diego2704/Clifford-Sensors/tesis/DOCUMENTACIÓN/RUP/DIAGRAMA DE SECUENCIAS.docx

# DIAGRAMAS DE SECUENCIA

Tabla de contenidos

1 | Comunicación en tiempo real de los sensores | …1
2 | Comunicación entre Arduino Nano | …2
3 | Comunicación entre Arduino Nano y Raspberry Pi | …3
4 | Detección de Gases. | …4
5 | Debe ser capaz de adaptarse a situaciones imprevistas o escenarios no programados, demostrando flexibilidad y toma de decisiones autónomas. | …5
6 | Se requiere que la plataforma opere de manera eficiente desde el punto de vista energético para maximizar su autonomía y minimizar el impacto ambiental. | …6
7 | Generación de Comandos por Entrada de Voz. | …7
8 | Medición del esfuerzo en las patas de la plataforma cuadrúpeda | …8
9 | Medición de la Orientación de la Plataforma | …9
10 | Estimación de la Posición utilizando GPS NEO6M | …10
11 | Medición del Consumo de Voltaje y Corriente | …11
12 | Interfaz de Usuario Intuitiva y Efectiva. | …12

1. Comunicación en tiempo real de los sensores.

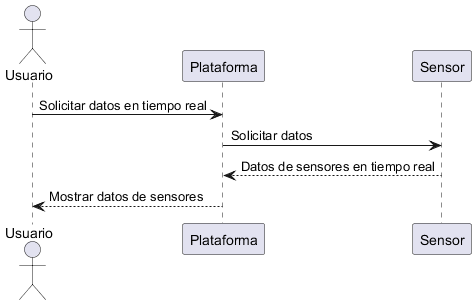
[picture p4: figure]

2. Comunicación entre Arduino Nano.

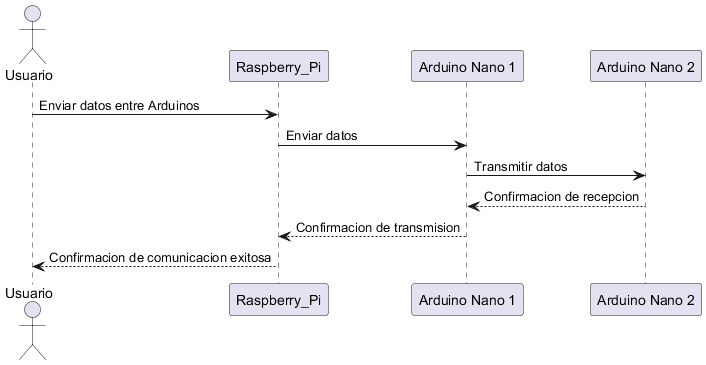
[picture p5: figure]

3. Comunicación entre Arduino Nano y Raspberry Pi.

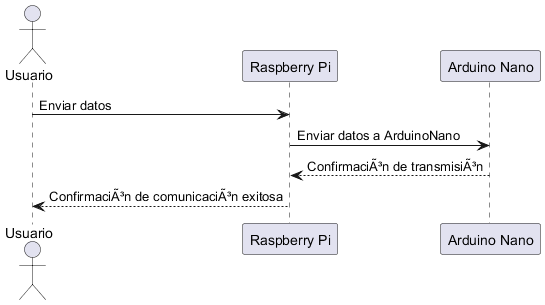
[picture p6: figure]

4. Detección de Gases.

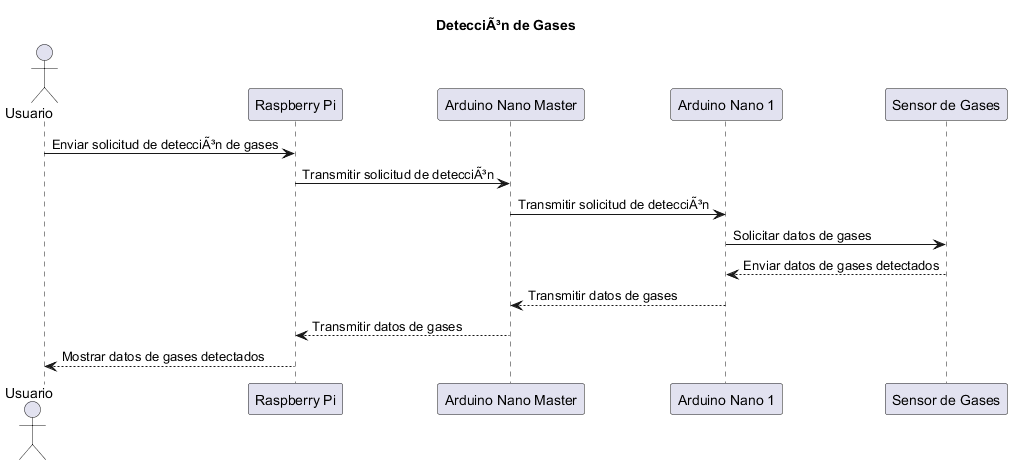
[picture p7: figure]

5. Detección de Objetos por Cámara.

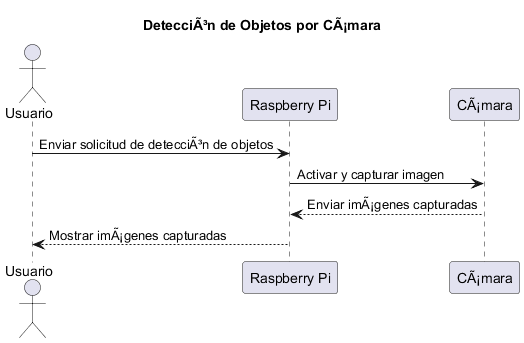
[picture p8: figure]

6. Detección de objetos por LIDAR 2D

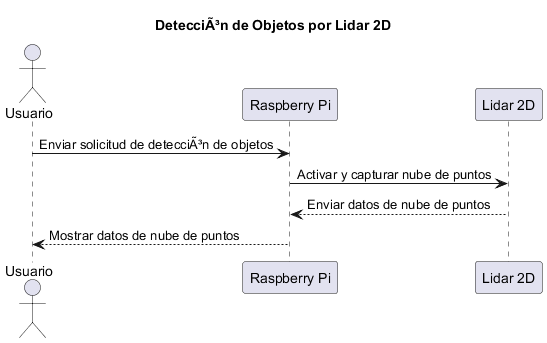
[picture p9: figure]

7. Generación de Comandos por Entrada de Voz.

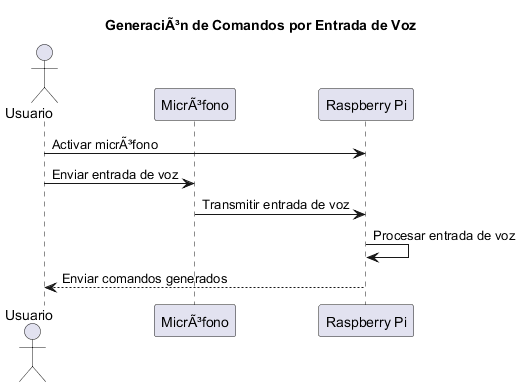
[picture p10: figure]

8. Medición del esfuerzo en las patas de la plataforma cuadrúpeda

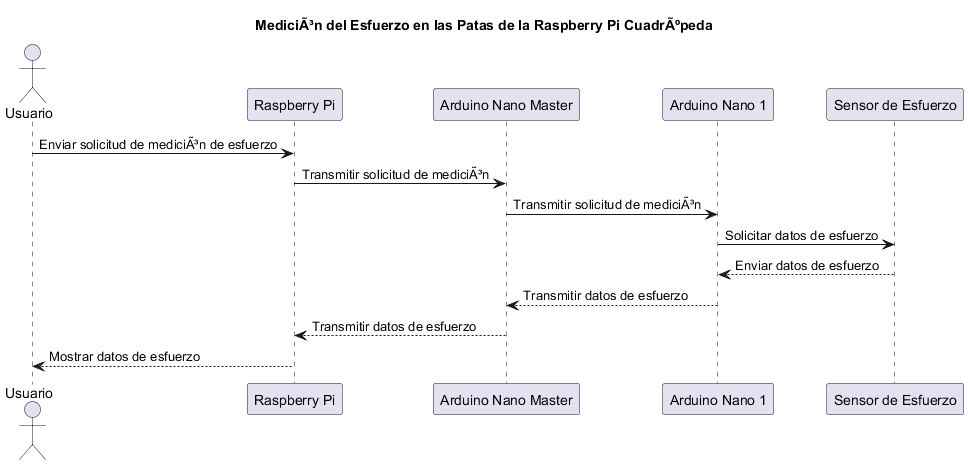
[picture p11: figure]

9. Medición de la Orientación de la Plataforma.

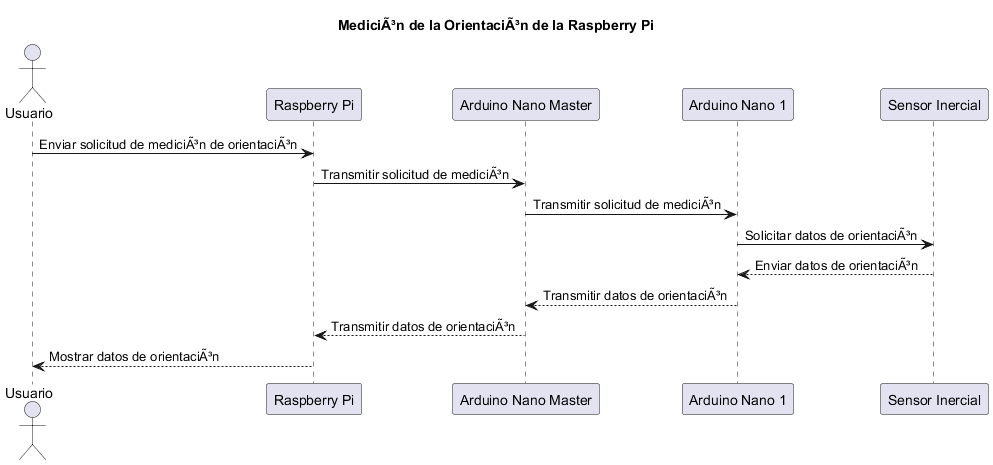
[picture p12: figure]

10. Estimación de la Posición utilizando GPS NEOM8N

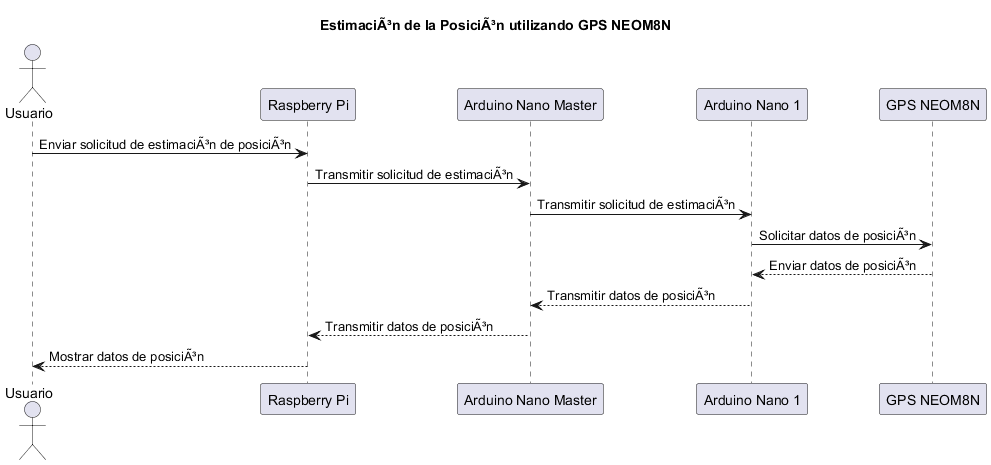
[picture p13: figure]

11. Medición del Consumo de Voltaje y Corriente

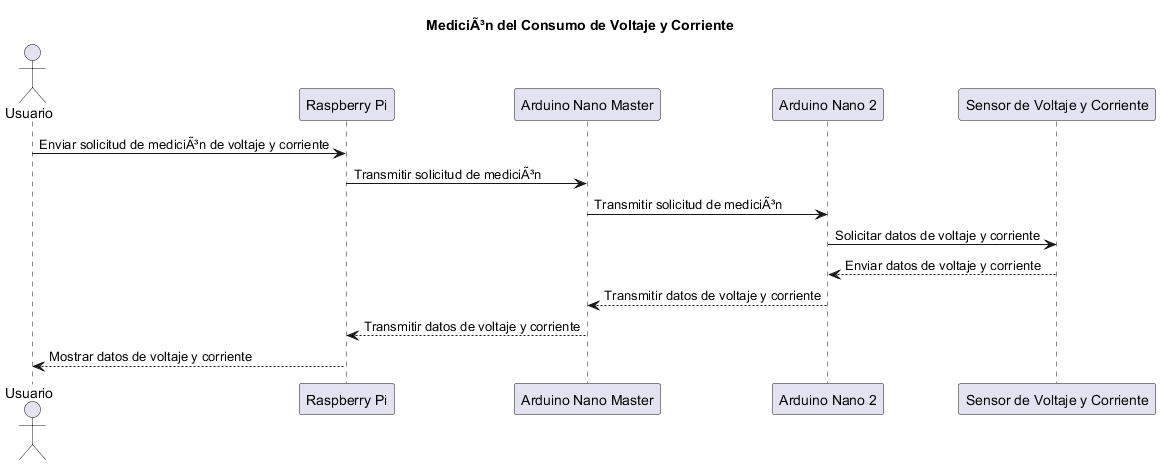
[picture p14: figure]

12. Interfaz de Usuario Intuitiva y Efectiva.

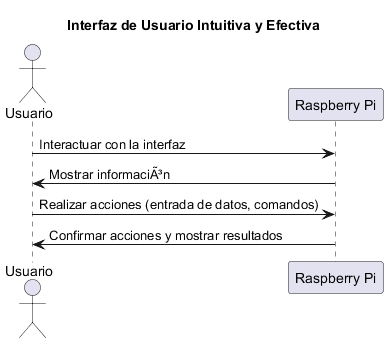
[picture p15: figure]
