diego2704/Clifford-Sensors/tesis/DOCUMENTACIÓN/RUP/DIAGRAMA_DE_CLASES.docx

DIAGRAMA DE CLASES

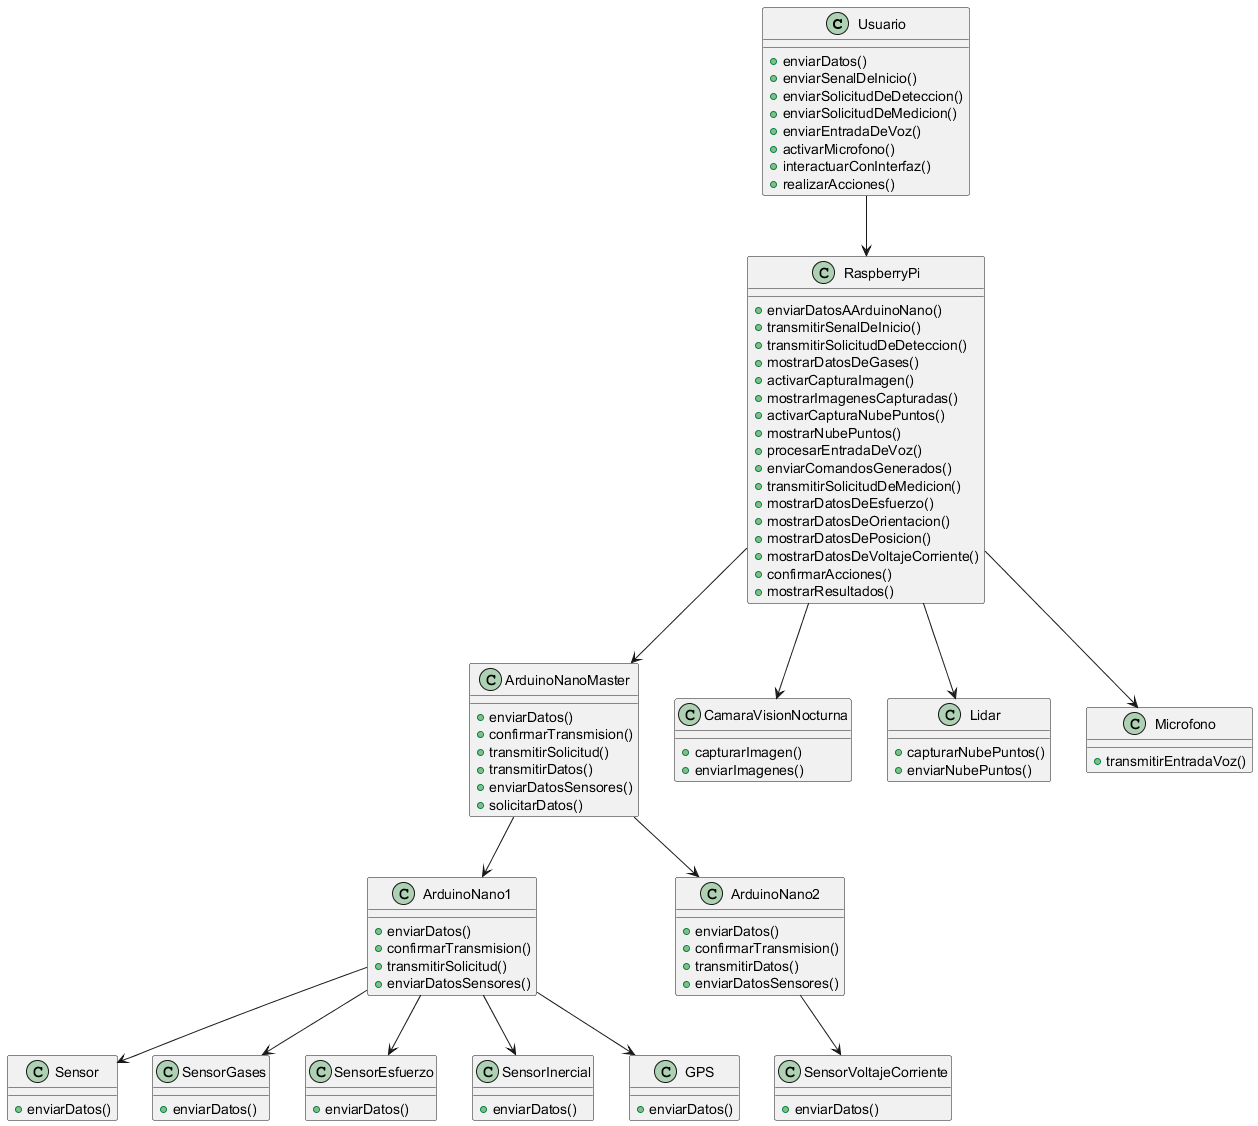
[picture p16: figure]
