diego2704/Clifford-Sensors/tesis/DOCUMENTACIÓN/ESQUEMATICO/esquematico.png

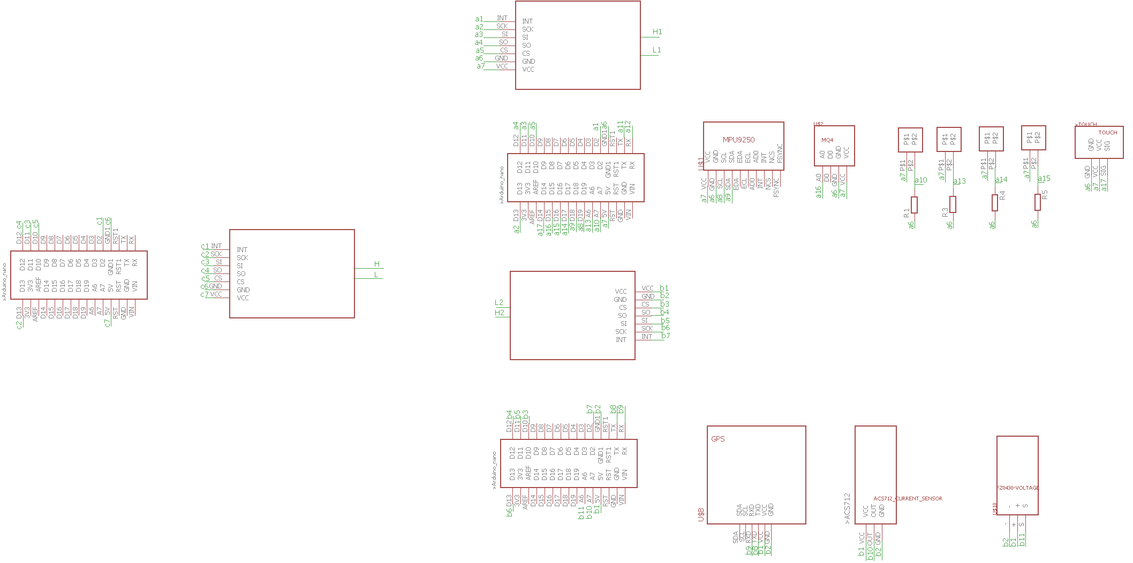
tesis/DOCUMENTACIÓN/ESQUEMATICO/esquematico.png
