diego2704/Clifford-Sensors/tesis/DOCUMENTACIÓN/ESQUEMATICO/PCB1.png

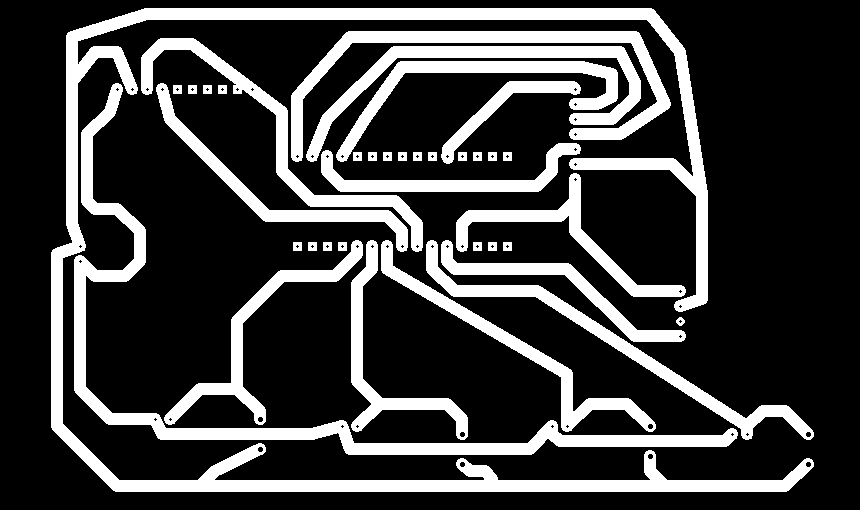
tesis/DOCUMENTACIÓN/ESQUEMATICO/PCB1.png
