diego2704/Clifford-Sensors/tesis/DOCUMENTACIÓN/ESQUEMATICO/PCB2.png

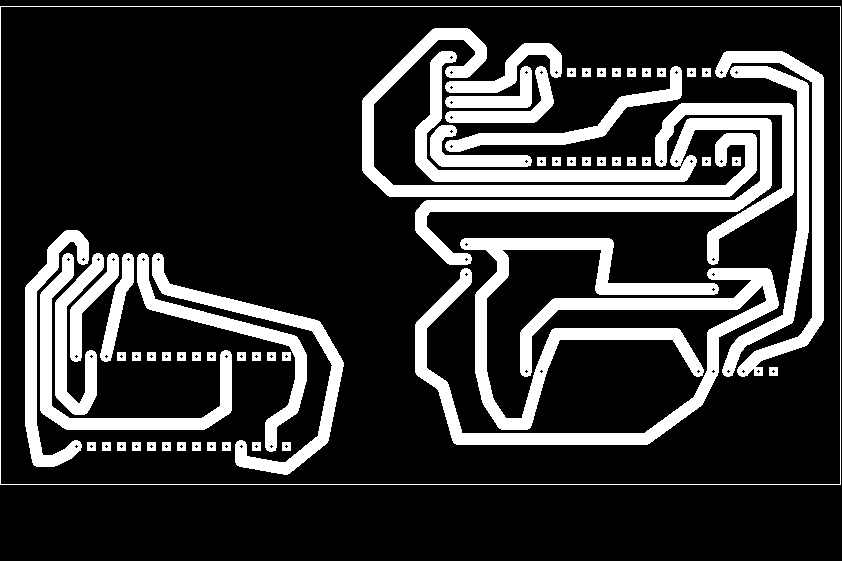
tesis/DOCUMENTACIÓN/ESQUEMATICO/PCB2.png
