diego2704/Clifford-Sensors/tesis/DOCUMENTACIÓN/EVIDENCIAS/Imagen de WhatsApp 2024-08-28 a las 14.34.12_500f0fdd.jpg

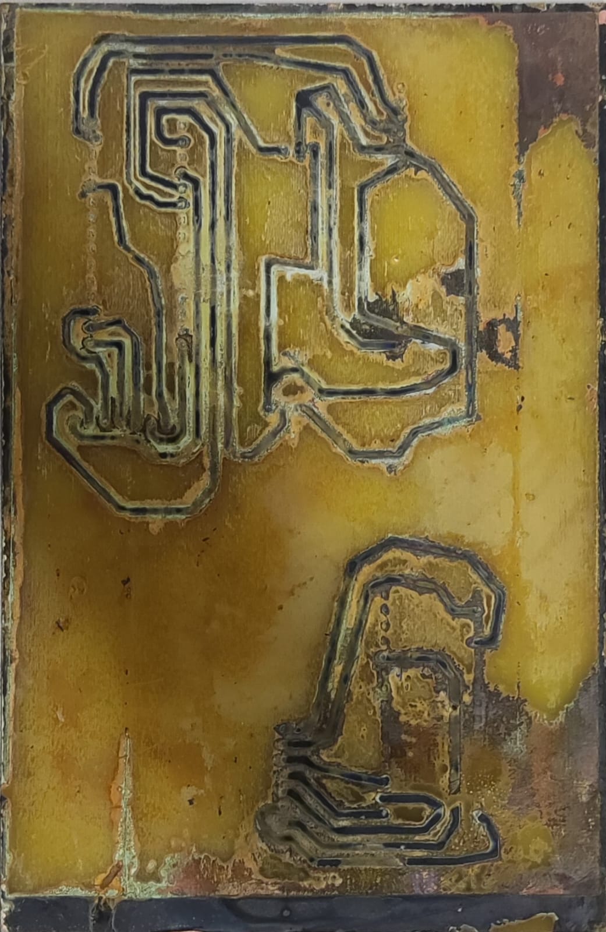
tesis/DOCUMENTACIÓN/EVIDENCIAS/Imagen de WhatsApp 2024-08-28 a las 14.34.12_500f0fdd.jpg
