diego2704/Clifford-Sensors/tesis/DOCUMENTACIÓN/EVIDENCIAS/Imagen de WhatsApp 2024-08-28 a las 14.34.12_a7c47f93.jpg

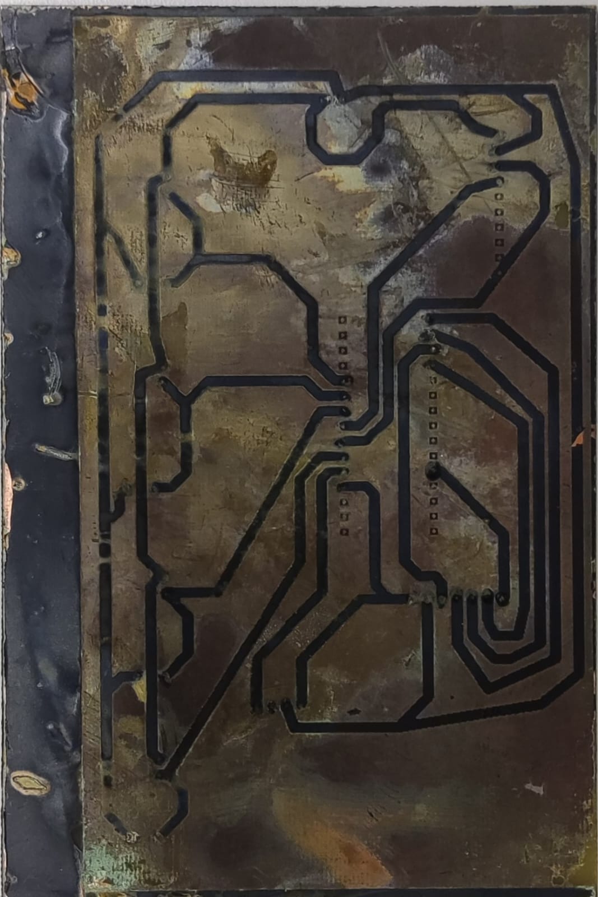
tesis/DOCUMENTACIÓN/EVIDENCIAS/Imagen de WhatsApp 2024-08-28 a las 14.34.12_a7c47f93.jpg
