diego2704/Clifford-Sensors/tesis/CODIGOS/1.Interfaz/segunda entrega/POCHITA_v30.stl

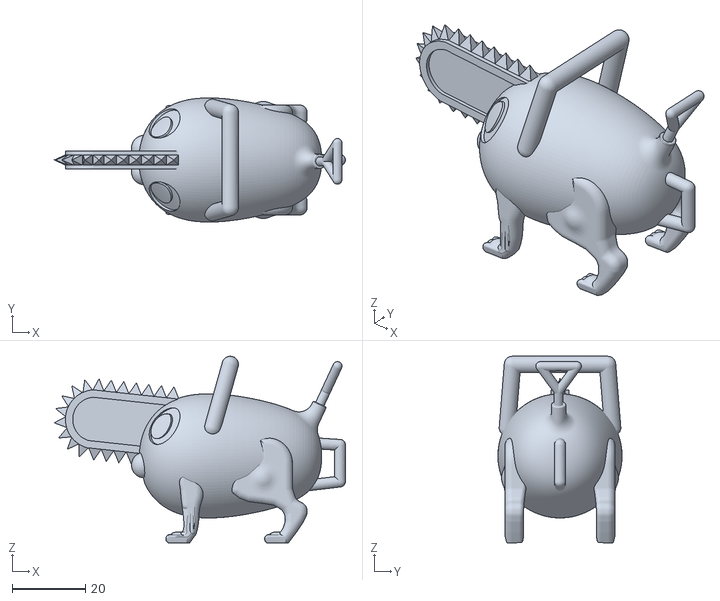
[picture p27: CAD file, 2024-10-07]
tesis/CODIGOS/1.Interfaz/segunda entrega/POCHITA_v30.stl
79.5 x 33.9 x 51.0
