diego2704/Clifford-Sensors/(list of files, drawings)

Other design files:
tesis/CODIGOS/esquematico_doggy.fzz
