diego2704/Clifford-Sensors/tesis/DOCUMENTACIÓN/ESQUEMATICO/es11quematico_tesis_brd.brd

## EAGLE design tesis/DOCUMENTACIÓN/ESQUEMATICO/es11quematico_tesis_brd.brd (2024-08-28)

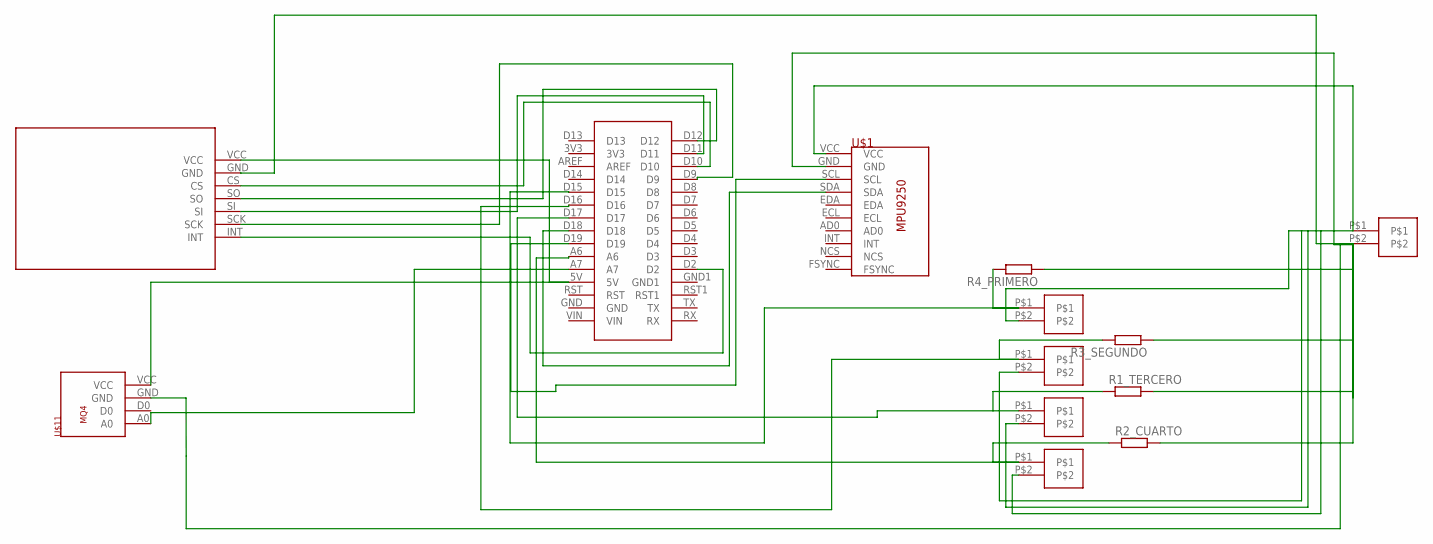
[picture p28: schematic es11quematico_tesis_brd.sch]

Parts:
ALIMENTACION: FSR402
CUARTO_FSR: FSR402
PRIMER_FSR: FSR402
R1_TERCERO, R2_CUARTO, R3_SEGUNDO, R4_PRIMERO: R-EU_0613/5V; P0613V
SEGUNDO_FSR: FSR402
TERCER_FSR: FSR402
U$1: MPU9250
U$2: ARDUINO-NANO
U$8: MCP2515
U$11: MQ4

Connections:
unnamed: ALIMENTACION.P$1, CUARTO_FSR.P$2, PRIMER_FSR.P$2, SEGUNDO_FSR.P$2, TERCER_FSR.P$2, U$1.VCC
unnamed: U$2.D10, U$8.CS
unnamed: ALIMENTACION.P$2, R1_TERCERO.2, R2_CUARTO.2, R3_SEGUNDO.1, R4_PRIMERO.1, U$1.GND, U$8.GND, U$11.GND
unnamed: U$2.D12, U$8.SO
unnamed: U$2.D11, U$8.SI
unnamed: U$2.D9, U$8.SCK
unnamed: U$2.D2, U$8.INT
unnamed: PRIMER_FSR.P$1, R4_PRIMERO.2, U$2.D15
unnamed: U$2.A7, U$11.A0
unnamed: U$1.SCL, U$2.D19
unnamed: U$1.SDA, U$2.D18
unnamed: CUARTO_FSR.P$1, R2_CUARTO.1, U$2.A6
unnamed: R1_TERCERO.1, TERCER_FSR.P$1, U$2.D17
unnamed: R3_SEGUNDO.2, SEGUNDO_FSR.P$1, U$2.D16
unnamed: U$2.5V, U$8.VCC, U$11.VCC

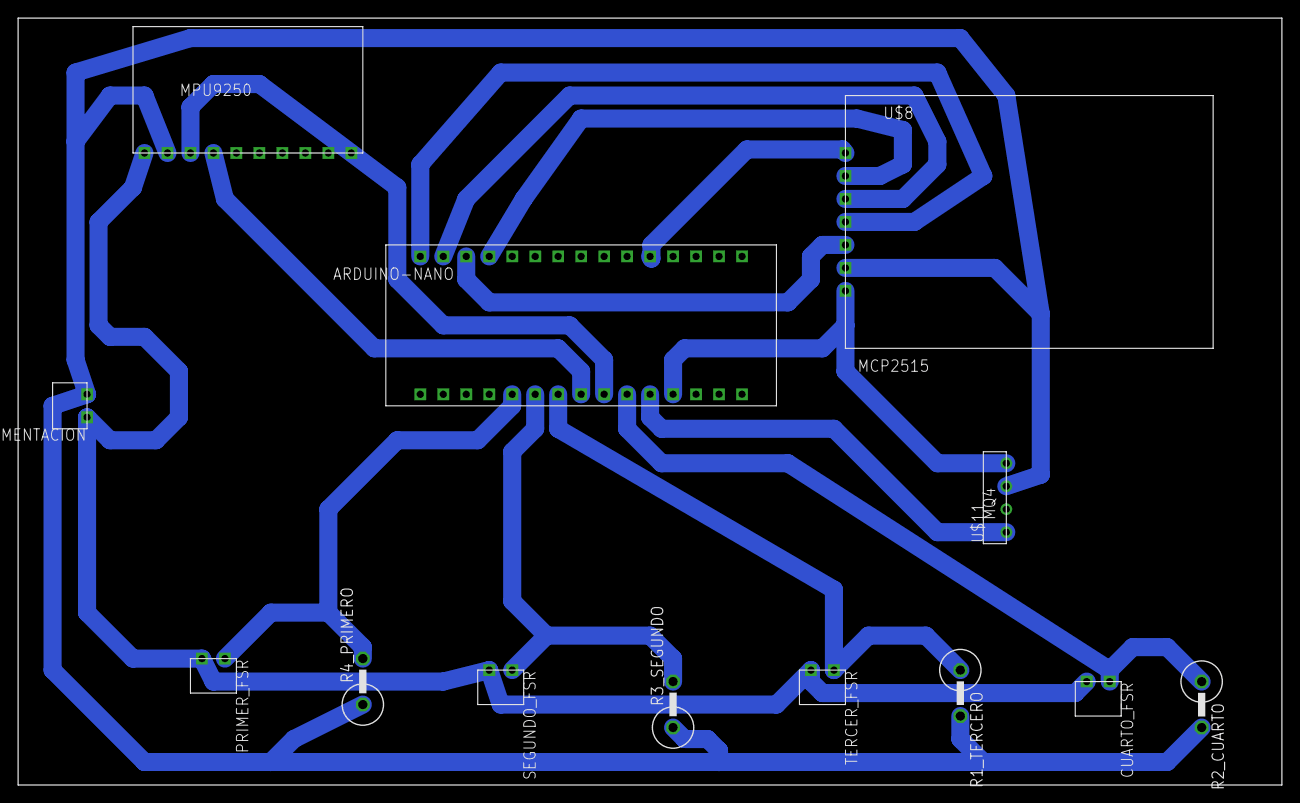
[picture p29: board es11quematico_tesis_brd.brd from above]

Board: 2 copper layers, 139.7 x 84.8 mm, 13 parts (0 on the bottom side), 15 nets.
