diego2704/Clifford-Sensors/tesis/CODIGOS/esquematico.sch

## EAGLE design tesis/CODIGOS/esquematico.sch (2024-08-21)

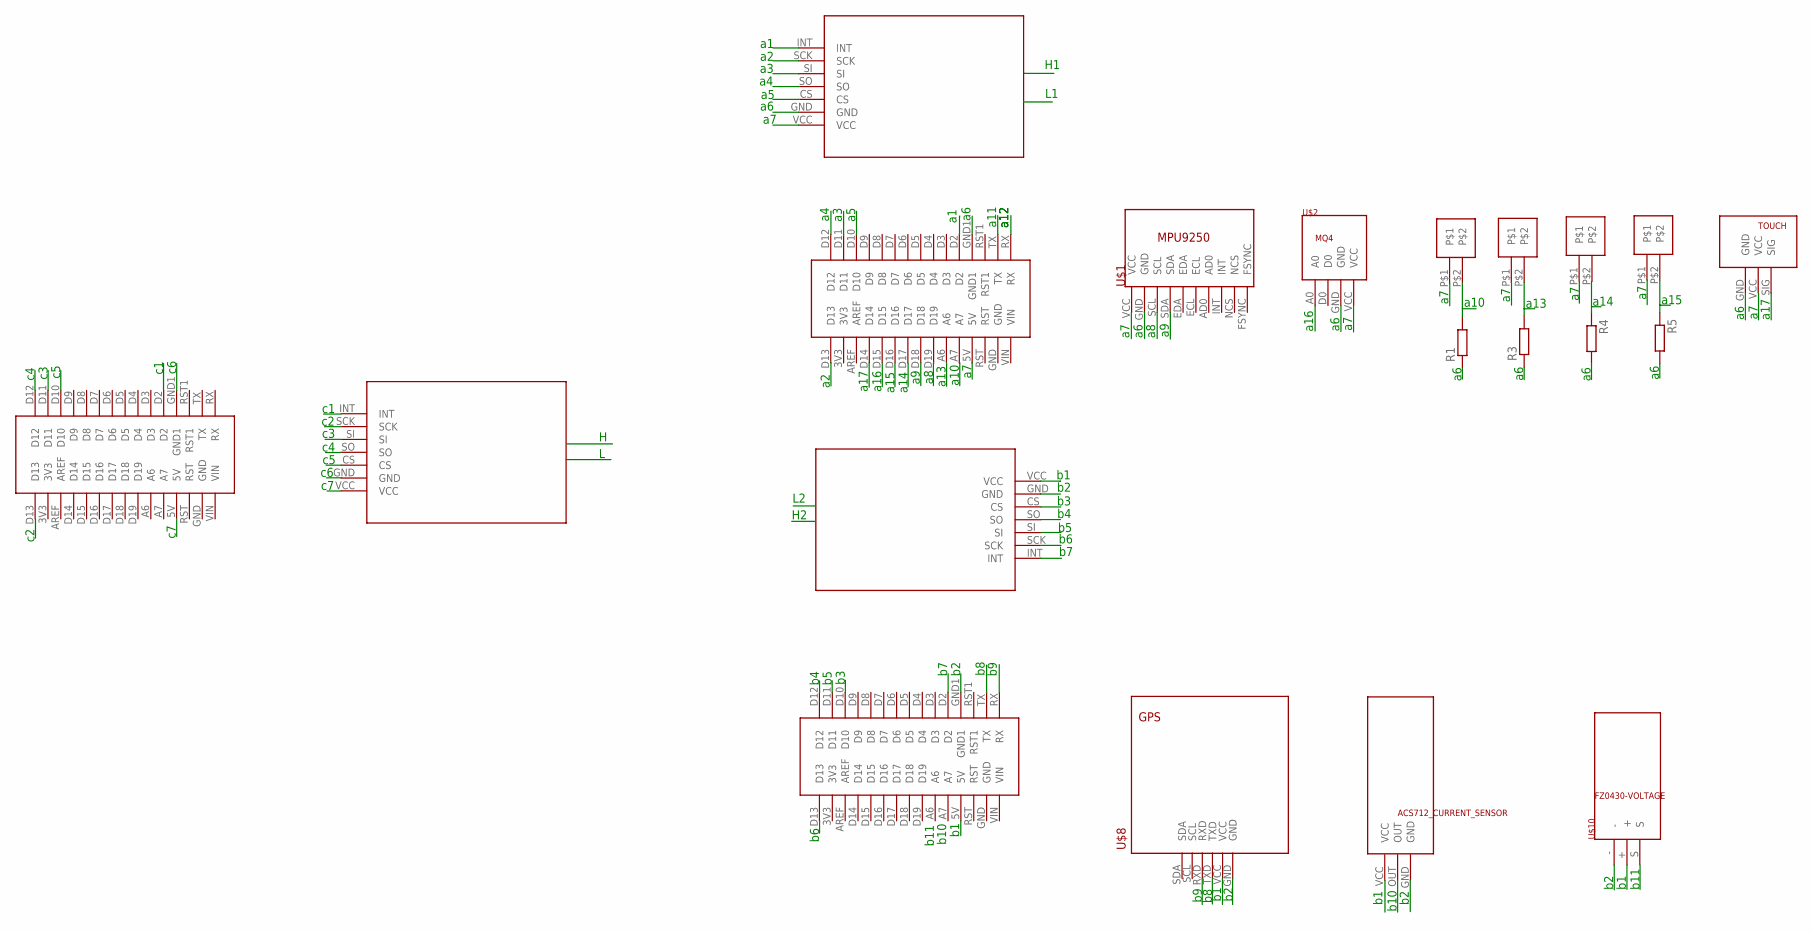
[picture p30: schematic esquematico.sch]

Parts:
R1, R3, R4, R5: R-EU_0204/5; 0204/5
U$1: MPU9250
U$2: MQ4
U$3, U$4, U$5, U$6: FSR402
U$7: TOUCH
U$8: GPS
U$9, U$15, U$16: ARDUINO-NANO
U$10: FZ0430-VOLTAGE
U$11: ACS712_CURRENT_SENSOR; ACS712-VOLTAGE
U$12, U$13, U$14: MCP2515

Notes on the sheet:
a10
a11
a12
a13
a14
a15
a16
a17
b10
b11
